konsk/ALiS/Files/Readme_(file_info)..md

 ## Αρχεία  

Σε αυτό τον φάκελλο βρίσκονται τα εγειρίδια χρήσης για τα ακόλουθα εξαρτήματα:

α) ηλεκτρονικά κυκλώματα (αισθητήρες)

β) 2 διδακτικά σενάρια με τη μορφή διδακτικών παρεμβάσεων (αρχείο: [Arduino_activities](https://github.com/konsk/ALiS/blob/master/Files/Arduino_activities.pdf))
