konsk/ALiS/Files/Edu_activity (Arduino_activities).pdf

Διαθεματική διδακτική παρζμβαςη ςτα μαθήματα τησ Φυςικήσ – Πληροφορικήσ Γ’ Γυμναςίου | .

Κωνςταντίνοσ Κωνςταντινίδησ - Ηλεκτρονικόσ Φυςικόσ Μ.Sc.

Διδακτικά ςενάρια (παρεμβάςεισ)

Διδακτικζσ ενότητεσ:

α) Χαρακτηριςτικά μεγζθη του κφματοσ - Κυματικά φαινόμενα: Ανάκλαςη κυμάτων και διάθλαςη των μηχανικών

κυμάτων

β) Εφαρμογζσ αρχών διατήρηςησ ςτη μελζτη απλών ηλεκτρικών κυκλωμάτων - Συνδεςμολογία αντιςτατών ςε

ςειρά

Ομάδα-ςτόχοσ:

Μαθητζσ τάξησ Γ Γυμναςίου

Χρήςτεσ

Καθηγητζσ και μαθητζσ Γ Γυμναςίου

Υλικοτεχνική υποδομή:

Καταςκευή που περιγράφεται ςτη ςελίδα https://github.com/konsk/ALiS , φορητόσ ηλεκτρονικόσ υπολογιςτήσ,

βιντεοπροβολζασ.

Προηγοφμενεσ γνώςεισ για:

α) την καταςκευή

βαςικζσ γνώςεισ ςτην αρχιτεκτονική υπολογιςτών και ςτον προγραμματιςμό ηλεκτρονικών υπολογιςτών

β) τισ διδακτικζσ παρεμβάςεισ

ζννοιεσ όπωσ ζνταςη ηλεκτρικοφ ρεφματοσ, διαφορά δυναμικοφ, αντίςταςη αγωγοφ, ευθφγραμμη ομαλή κίνηςη,

ταλαντώςεισ, κφματα

Μαθηςιακοί ςτόχοι:

- Λειτουργία ςυςτημάτων μετρήςεων και ελζγχου (μζτρηςη, αξιολόγηςη μετρήςεων, εκτζλεςη αποφάςεων)

(και για τισ δυο ενότητεσ)

- Χαρακτηριςτικά μεγζθη ενόσ κφματοσ
- Τάςη ςτα άκρα αντιςτάτη ςε ςφνδεςη ςε ςειρά

Εκτιμώμενη διάρκεια:

2 διδακτικζσ ώρεσ (1 διδακτική ώρα για κάθε φφλλο εργαςίασ)

Οργάνωςη διδαςκαλίασ (διδακτικήσ παρζμβαςησ):

Το ςενάριο μπορεί να υλοποιηθεί ςε ςχολική αίθουςα. Ο διδάςκων εκτελεί τον κώδικα, κάνοντασ χρήςη του

ςυςτήματοσ A.Li.S., ηλεκτρονικό υπολογιςτή και βιντεοπροβολζα και οι μαθητζσ ςυμπληρώνουν τα φφλλα

εργαςίασ 1 και 2.
