konsk/ALiS/Schematics-Images/ldr_schem.jpg

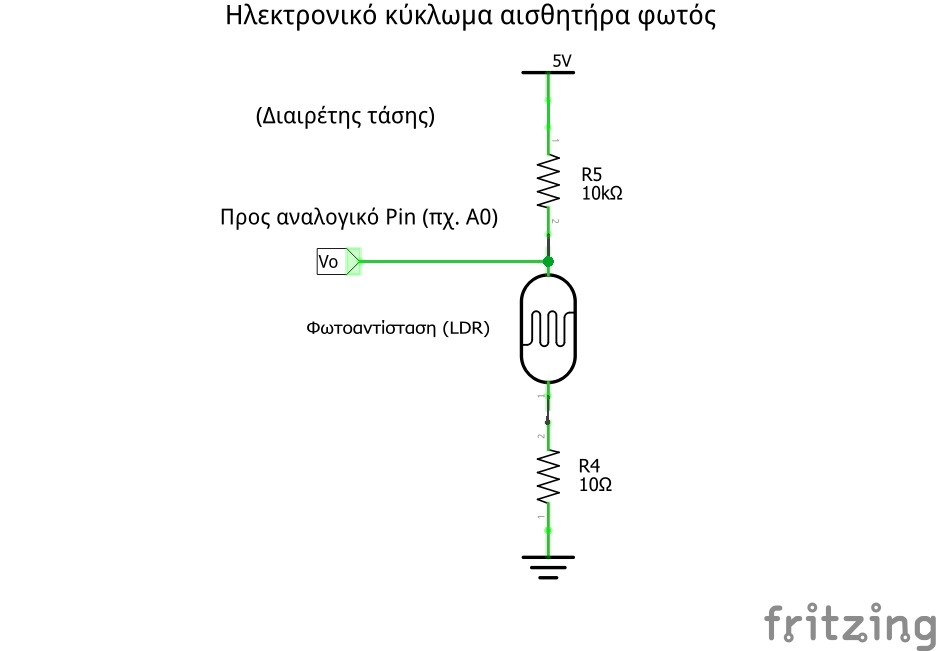
Schematics-Images/ldr_schem.jpg
