konsk/ALiS/Schematics-Images/Led_strip_driver_schem.jpg

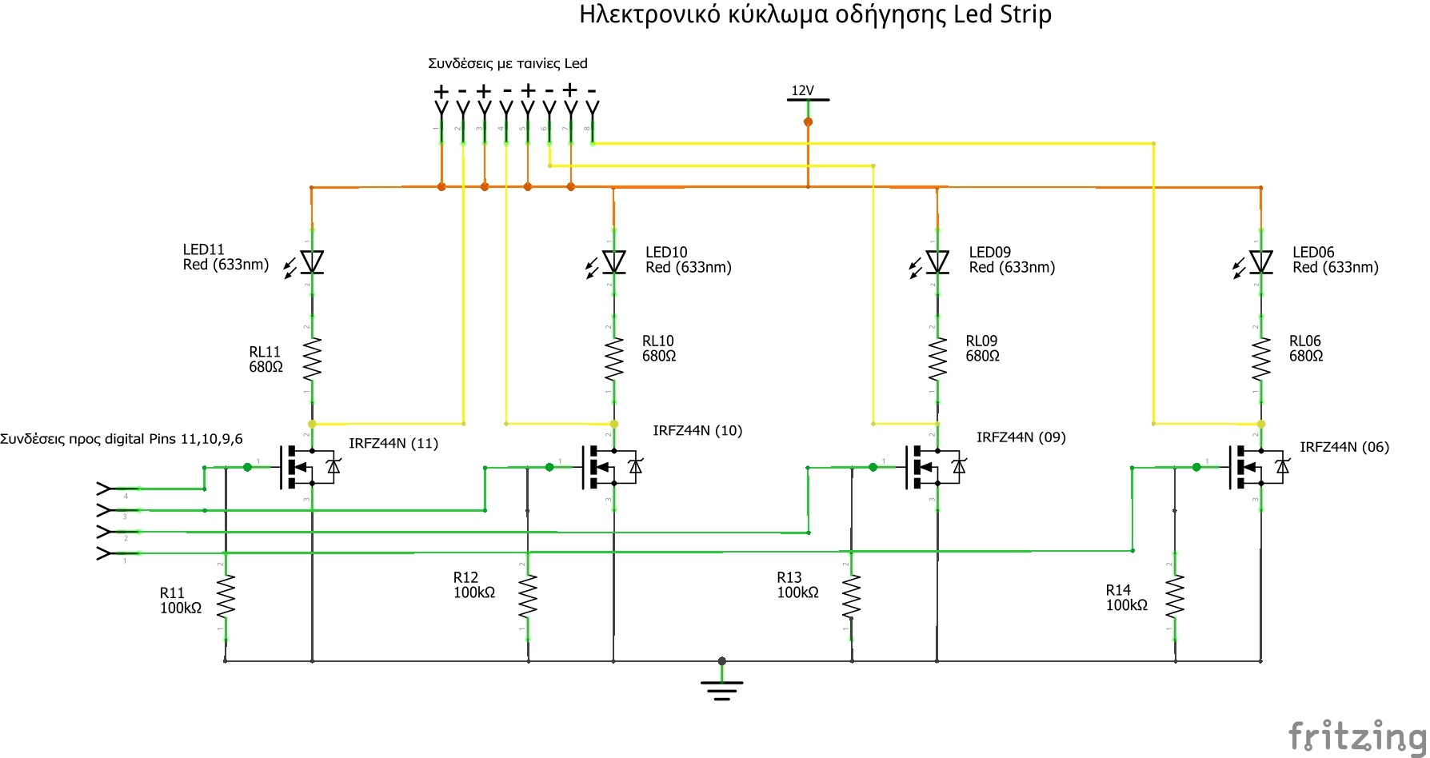
Schematics-Images/Led_strip_driver_schem.jpg
