konsk/ALiS/Materials.md

### Υλικά για την κατασκευή του συστήματος A.Li.S. και της μακέτας (προσομοίωση αίθουσας)
|**Απαραίτητα υλικά**|**Προαιρετικά υλικά**|
:-------------------------:|:-------------------------:
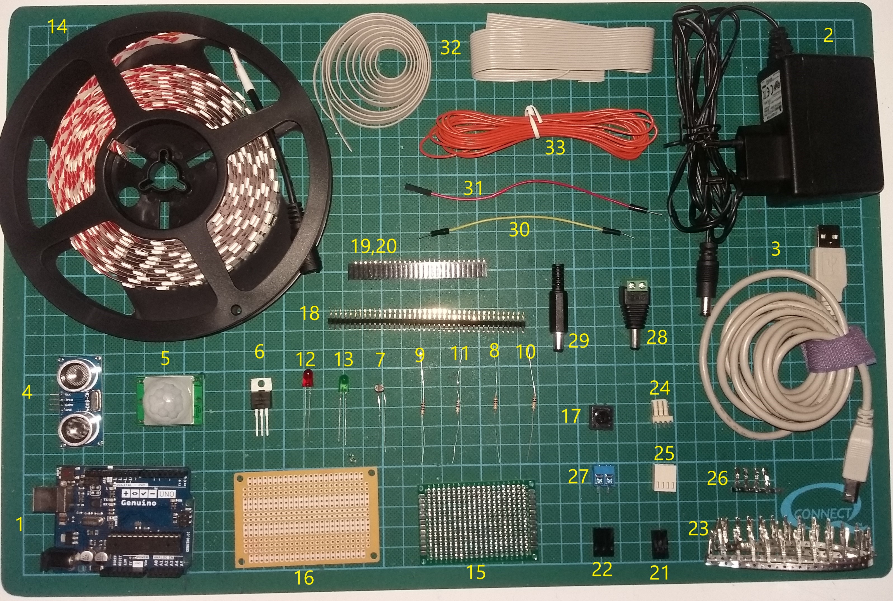
[picture p11: Schematics-Images/materials_A.jpg]
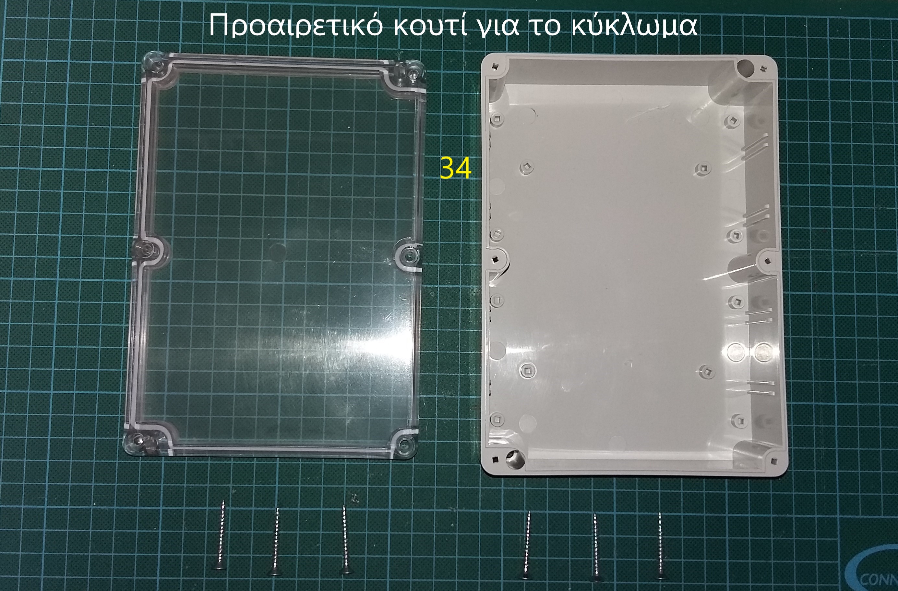
[picture p12: Schematics-Images/materials_B.jpg]
  |  

Α/Α | ΥΛΙΚΑ ΗΛΕΚΤΡΟΝΙΚΩΝ ΚΥΚΛΩΜΑΤΩΝ | Τεμάχια | Κόστος / Τεμάχιο (Ευρώ) | Κόστος (Ευρώ) | Κατάστημα
:--: | :--: | :--: | :--: | :--: | :--:
1 | Πλακέτα Arduino Uno (Μικροελεγκτής ATmega328) | 1 | 22,9 | 22,9 | [Grobotronics](https://grobotronics.com/arduino-uno-rev3.html)
2 | Τροφοδοτικό 12VDC 1A | 1 | 4 | 4 | [Grobotronics](https://grobotronics.com/12v-1a-output-5.5x2.1-psu-1601.html)
3 | Καλώδιο USB 2.0 A σε B 0.5m Γκρί | 1 | 1,3 | 1,3 | [Grobotronics](https://grobotronics.com/usb-2.0-a-b-0.5m.html)
4 | Αισθητήρας απόστασης (πχ HC-SR04) | 1 | 2,5 | 2,5 | [Grobotronics](https://grobotronics.com/ultrasonic-sensor-sr04.html)
5 | Αισθητήρας ανίχνευσης κίνησης (HC-SR501) | 1 | 2,8 | 2,8 | [Grobotronics](https://grobotronics.com/pir-sensor-module.html)
6 | IRFZ44N NMOSFET transistor | 4 | 0,8 | 3,2 | [Grobotronics](https://grobotronics.com/mosfet-n-channel-55v-41a-irfz44npbf.html)
7 | Φωτοαντιστάσεις-LDR 5mm (10K-20K) | 4 | 0,2 | 0,8 | [Grobotronics](https://grobotronics.com/photo-resistor-ldr-5mm.html)
8 | Αντιστάτες 10K ισχύος 1/4W ανοχής 5% | 4 | 0,01 | 0,04 | [Grobotronics](https://grobotronics.com/carbon-1-4w-5-10kohm.html)
9 | Αντιστάτες 10Ω ισχύος 1/4W ανοχής 5% | 4 | 0,01 | 0,04 | [Grobotronics](https://grobotronics.com/carbon-1-4w-5-10ohm.html)
10 | Aντιστάτες 100K ισχύος 1/4W ανοχής 5% | 4 | 0,01 | 0,04 | [Grobotronics](https://grobotronics.com/carbon-1-4w-5-100kohm.html)
11 | Αντιστάτες 680 ισχύος 1/4W ανοχής 5% | 4 | 0,01 | 0,04 | [Grobotronics](https://grobotronics.com/carbon-1-4w-5-680ohm.html)
12 | Led κόκκινες 5mm (απλές-όχι ισχύος) | 4 | 0,1 | 0,4 | [Grobotronics](https://grobotronics.com/led-diffused-5mm-elrd.html)
13 | Led πράσινες 5mm (απλές-όχι ισχύος) | 1 | 0,1 | 0,1 | [Grobotronics](https://grobotronics.com/led-diffused-5mm.html)
14 | 80cm Ταινία LED 14.4 W/m IP20 Ψυχρό Χρώμα | 0,8 | 2,64 | 2,1 | [Ledcosmos](http://ledcosmos.gr/led-tainia-14.4w-ip20-psixro-xrwma-6000k-smd.html)
15 | Πλακέτα Διάτρητη 30x70mm - Διπλής Όψης | 1 | 0,5 | 0,5 | [Grobotronics](https://grobotronics.com/30x70mm.html)
16 | Διάτρητη πλακέτα 72x47mm- Μονής όψης | 1 | 1 | 1 | [Grobotronics](https://grobotronics.com/72x47mm.html)
17 | Tact Switch 12x12mm 7.3mm  | 1 | 0,15 | 0,15 | [Grobotronics](https://grobotronics.com/72x47mm.html)
18 | Pin Header 1x40 Male 2.54 mm  | 1 | 0,25 | 0,25 | [Grobotronics](https://grobotronics.com/pin-header-1x40-male-2.54-mm-black.html)
19 | Pin Header 1x10 Female Right Angle  | 1 | 0,15 | 0,15 | [Grobotronics](https://grobotronics.com/pin-header-1x10-female-right-angle.html)
20 | Pin Header 1x6 Female 2.54mm Right Angle  | 2 | 0,2 | 0,4 | [Grobotronics](https://grobotronics.com/pin-header-1x6-female-2.54mm-right-angle.html)
21 | Dupont Terminal 3 Pins 2.54mm | 10 | 0,05 | 0,5 | [Grobotronics](https://grobotronics.com/terminal-female-3-pins-2.54mm-dupont.html)
22 | Dupont Terminal 4 Pins 2.54mm | 2 | 0,06 | 0,12 | [Grobotronics](https://grobotronics.com/terminal-female-4-pins-2.54mm-dupont.html)
23 | Crimp For Dupont Female | 38 | 0,04 | 1,52 | [Grobotronics](https://grobotronics.com/crimp-for-dupont-female.html)
24 | Molex Connector Male 4-Pin   2.54mm | 1 | 0,08 | 0,08 |[Grobotronics](https://grobotronics.com/molex-connector-male-4-pin-2.54mm.html)
25 | Molex Connector Female 4-Pin   2.54mm | 1 | 0,03 | 0,03 | [Grobotronics](https://grobotronics.com/molex-connector-female-4-pin-2.54mm.html)
26 | Crimp For Molex Connectors | 4 | 0,02 | 0,08 | [Grobotronics](https://grobotronics.com/crimp-for-molex-connectors.html)
27 | Screw Terminal 2P 5mm  (κλέμες πλακέτας) | 9 | 0,2 | 1,8 |[Grobotronics]( https://grobotronics.com/screw-terminal-2p-5mm.html)
28 | DC Power Jack 5.5 x 2.1mm Barrel | 1 | 0,6 | 0,6 | [Grobotronics](https://grobotronics.com/dc-power-jack-5.5-x-2.1mm-barrel.html)
29 | DC Power Plug 5.5 x 2.1mm | 1 | 0,25 | 0,25 | [Grobotronics](https://grobotronics.com/dc-power-plug-5.5-x-2.1mm.html)
30 | Καλώδια Jumber 15cm male to male (pack of 10) | 1 | 1,8 | 1,8 | [Grobotronics](https://grobotronics.com/jumper-wires-15cm-male-to-male-pack-of-10.html)
31 | Καλώδια Jumber 15cm male to female (pack of  10) | 1 | 1,8 | 1,8 | [Grobotronics](https://grobotronics.com/jumper-wires-15cm-female-to-male-pack-of-10.html)
32 | 16x1m καλώδιο τύπου ribbon | 8 | 0,7 | 5,6 | [Grobotronics](https://grobotronics.com/ribbon-cable-28awg-0.081mm2-16-wirevv.html)
33 | Μονόκλωνο καλώδιο (1m) | 1 | 0,05 | 0,05 | [Grobotronics](https://grobotronics.com/single-core-wire-wrapping-wire-green-1000ft-305m.html)
34 | Project Box 176x126x57.4mm -   Grey (Kradex Z74JPH ABS)  (προαιρετικό) | 1 | 4,9 | 4,9 | [Grobotronics](https://grobotronics.com/176x126x57.4mm-grey-kradex-z74jph-abs.html)
35 | Αντιστάτες 180Ω ισχύος 1/4W ανοχής 5% | 4 | 0,01 | 0,04 | [Grobotronics](https://grobotronics.com/carbon-1-4w-5-180ohm.html)
  |   |   |   |   |  
**Α/Α** |**ΥΛΙΚΑ ΜΑΚΕΤΑΣ** | **Τεμάχια** | **Κόστος** / **Τεμάχιο (Ευρώ)** | **Κόστος (Ευρώ)** | **Κατάστημα** 
36 | Μακετοχαρτο λευκό 10x50x70cm (Y-Π-Μ) | 3 | 4,99 | 14,97 | [Πλαίσιο](https://www.plaisio.gr/zografiki-diy/maketa/xartonia/Neofoam-Paper-Board-50x70cm-10mm-10MM-50X70.htm)
37 | Χαρτόνι 50x70 (οποιοδήποτε ανοιχτό χρώμα) | 2 | 0,99 | 1,98 | [Jumbo](https://www.e-jumbo.gr/scholika/cheirotechnia/chartonia-cheirotechnias/chartonia-typou-canson/chartoni-typou-canson-portokali-50x70_68951)
38 | Θερμοκόλλα | 1 | 1,49 | 1,49 | [Πλαίσιο](https://www.plaisio.gr/zografiki-diy/kataskeves-diy/thermokolisi/@Work-Ravdoi-Silikonis-11mmx20cm-6tem-AW10956.htm)
39 | Καρφίτσες | 1 | 0,49 | 0,49 | [Πλαίσιο](https://www.plaisio.gr/xartopoleio/promitheies-grafeiou/pinezes-karfitses/@Work-Steel-Pins-AW10872.htm)
40 | Δεματικά (zip ties) | 1 | 0,99 | 0,99 | [Πλαίσιο](https://www.plaisio.gr/desktop-laptop/periferiaka/cables-kalodia/Sentio-Cable-Ties-3-Dimensions-D12-75.htm)
41 | Μονωτική ταινία (λευκή) (πάχος 45mm) | 1 | 1,4 | 1,4 | [E-tools](https://www.etools.gr/index.php?route=product/product&path=9_135&product_id=3147)
 |  |  | ΣΥΝΟΛΙΚΟ ΚΟΣΤΟΣ | 83,17 |  

**Ειδικά εργαλεία και υλικά που θα χρειαστούν:**
- [Σταθμός κόλλησης](https://grobotronics.com/48w-zd99.html) ή [κολλητήρι](https://grobotronics.com/zd-200n-30w.html)
- [Κόλληση](https://grobotronics.com/14g-lead-free.html) (υλικό κόλλησης για πλακέτες) (Καλάι)
- [Πιστόλι σιλικόνης](https://grobotronics.com/mini-zd5b-20w.html)
- [Ράβδοι σιλικόνης](https://grobotronics.com/20cm-11.html)
- [Zip ties](https://grobotronics.com/cable-tie-100mm-black-100pcs.html) (υλικό κόλλησης για πλακέτες) ή Cable ties
