konsk/ALiS/(commit log)

2019-03-10 A.Li.S. ELectronic diagram
    Σχηματικό διάγραμμα συστήματος A.Li.S.
2019-03-10 Ηλεκρονικό διάγραμμα αισθητήρα φωτός
    Το κύκλωμα είναι ένας διαιρέτης τάσης, με μεταβλητή αντίσταση την LDR
2019-03-11 Ηλεκτρονικό διάγραμμα οδήγησης Led Strip
    Το κύκλωμα οδήγησης αποτελείται από 4 ηλεκτρονικούς διακόπτες ισχύος με 4 MOSFET IRFZ44N και 4 led για ένδειξη της λειτουργίας κάθε ηλεκτρονικού διακόπτη
2019-03-11 Διάγραμμα ηλετρονικού κυκλώματος οδήγησης Led Strip
    Το κύκλωμα αποτελείται από 4 ηλεκτρονικούς διακόπτες με 4 N-MOSFET ισχύος IRFZ44N και 4 led για ένδειξη λειτουργιας του κάθε διακόπτη.
2019-03-11 Διάγραμμα ηλεκτρονικού κυκλώματος αισθητήρα φωτός
    Το κύκλωμα (για κάθε αισθητήρα) αποτελεί έναν διαιρέτη τάσης με μεταβλητή αντίσταση μια LDR.
2019-03-11 Διάγραμμα συστήματος A.Li.S.
    Πλήρες διάγραμμα συστήματος A.Li.S. (Automatic Lighting System) με τα όλα τα εξαρτήματα: πλακέτα μικροελεγκτή, αισθητήρες, κύκλωμα οδήγησης Led Strip, Led Strip (όχι RGB).
2019-03-31 Create A.Li.S_bb_1.jpg
    Διάγραμμα συστήματος A.Li.S.
2019-03-31 A.Li.S. System
    Διάγραμμα συστήματος A.L.i.S.
2019-03-31 Διάγραμμα συστήματος A.L.i.S.
2019-03-31 Διάγραμμα συστήματος A.Li.S.
    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
2019-03-31 Διάγραμμα συστήματος AL.i.S.
2019-03-31 Διάγραμμα οδήγησης Led Strip
2019-03-31 Διάγραμμα κυκλώματος οδήγησης Led Strip
2019-03-31 Ηλεκτρονικό κύκλωμα αισθητήρας φωτός
2019-04-02 Create Materials
2019-04-02 Update Materials
2019-04-07 ALiS Ηλεκτρονικό σχέδιο
    Το ηλεκτρονιό κύκλωμα του συστήματος
2019-04-07 Ηλετκρονικό κύκλωμα αισθητήρα φωτός
    Ηλεκτρονικό κύκλωμα αισθητήρα φωτός
2019-04-07 Kύκλωμα οδήγησης ταινιών Led
    Μονάδα ισχύος. Ηλεκτρονικό κύκλωμα οδήγησης ταινιών led
2019-04-07 Κουτί
    Προαιρετικό κουτί για τα ηλεκτρονικά κυκλώματα
2019-04-07 Υλικά
    Απαραίτητα υλικά για τα κυκλώματα του συστήματος ALiS
2019-04-07 A.Li.S. Ηλεκτρονικό διάγραμμα
    Το ηλεκτρονικό κύκλωμα του συστήματος
2019-04-07 A.L.i.S. Ηλεκτρονικό διάγραμμα
    Ηλεκτρονικά σχέδιο (κυκλώματα συστήματος A.Li.S.)
2019-04-07 Dupont_connector
    Συνδετήρας αισθητήρων φωτός και άλλων αισθητήρων
2019-04-07 dupont_3
    Σύνδετήρας αισθητήρων
2019-04-09 materials_A
    Υλικά για τα ηλεκτρονικά κυκλώματα
2019-04-09 Materials_B
    Προαιρετικό κουτί για την ηλεκτρονική μονάδα ελέγχου και την ηλεκτρονικό κύκλωμα ισχύος.
2019-04-09 Button Pressed Function
2019-04-09 Adjust Led Strip Function
2019-04-09 View Function
    Εμφανίζει στην σειριακή θύρα τιμές φωτεινότητας από φωτοαντιστάσεις και led strip
2019-04-13 Rename Construction.md to Οδηγίες κατασκευής.md
2019-04-13 Update Οδηγίες κατασκευής.md
2019-04-13 Rename Οδηγίες κατασκευής.md to Construction-notes.md
